kurt-stolle/tue-dbl-venus/docs/pin layout.txt

Digital 0 - RX ZigBee module
Digital 1 - TX ZigBee module
Digital 2 - Ultrasonic Top (Echo Pin)
Digital 3 (PWM) - Ultrasonic Bottom (Echo Pin)
Digital 4 - Infrared Sample (bottom)
Digital 5 (PWM) - Infrared Lab (top)
Digital 6 (PWM) - Ultrasonic Bottom (Trigger Pin)
Digital 7 - left encoder
Digital 8 - right encoder
Digital 9 (PWM) - Ultrasonic Top (Trigger Pin)
Digital 10 (PWM) - grabber servo
Digital 11 (PWM) - ultrasound servo
Digital 12 - left servo
Digital 13 - right servo
Analog 0 - IR Left
Analog 1 - IR Right
Analog 2 - not used
Analog 3 - not used
Analog 4 - not used
Analog 5 - not used
