kurt-stolle/tue-dbl-venus/docs/Meetings/Agenda/Meeting Agenda 07.06.docx

# Meeting Agenda 07.06.16

- What we did last week
- What to do this week - Task division for this week - When to meet on Friday
- Who got a camera we can use?
- AOB
