kurt-stolle/tue-dbl-venus/docs/Meetings/Notes/2016-05-17.docx

# Venus OGO meeting

2016-05-17

De vergadering wordt gestart om 10:01

# Vorige week

…

# Status

Software loopt volgens schema.

Er moet een oplossing bedacht worden voor het bijhouden van de afgelegde snelheid.

Het IR-circuit werkt, alleen is een van de circuits niet goed gesoldeerd.

Test plan is nog niet mee begonnen.

Er is nog niet begonnen met tactiek.

# Planning volgende week

Alle test plans moeten af zijn.

Deze week moet communicatie en navigatie werken bijna.

# WVTTK

…
