kurt-stolle/tue-dbl-venus/docs/Design Report/gantt chart group 32.pdf

Venus Exploration Group 32 | May 10, 2016 http://

Project manager
Project dates | Apr 19, 2016 - Jun 21, 2016
Completion | 0%
Tasks | 28
Resources | 5

Gantt chart for group 32

Name | Begin date | End date
Task division | 4/19/16 | 4/25/16
Global setup | 4/19/16 | 4/25/16
Strategy choice | 4/19/16 | 4/25/16
Programming basics | 4/26/16 | 4/28/16
Utilitarian functions | 4/26/16 | 4/28/16
Examining robot functionality | 4/29/16 | 5/2/16
Design report | 4/26/16 | 4/29/16
Testing basic functionality on robot | 5/3/16 | 5/9/16
Developing basic algorithm | 5/3/16 | 5/9/16
Overall task division | 5/3/16 | 5/3/16
Making gantt chart | 5/3/16 | 5/6/16
Fix grabber | 5/3/16 | 5/3/16
Design circuit IR-sensor | 5/3/16 | 5/9/16
Testing ultrasonic sensor | 5/3/16 | 5/9/16
Testing XBee sensor | 5/3/16 | 5/9/16
Test IR-circuit | 5/10/16 | 5/12/16
Test plan: Identifying and grabbing the rocks | 5/10/16 | 5/16/16
Test plan; Boundary and cliff recognition | 5/13/16 | 5/16/16
Test plan: Detecting mountains | 5/13/16 | 5/16/16
Test plan: Communication | 5/17/16 | 5/19/16
Test plan: Navigation | 5/20/16 | 5/23/16
Choose strategy | 5/17/16 | 5/17/16
Testing IR sensors | 5/24/16 | 5/26/16
Main algorithm | 5/18/16 | 5/26/16
Final testing | 5/31/16 | 6/6/16
Write final report | 6/7/16 | 6/13/16
Video presentation deadline | 6/16/16 | 6/16/16
Final report deadline | 6/20/16 | 6/20/16
Venus Exploration Group 32 | May 10, 2016
Tasks | 2

Name | Default role
Kurt | undefined
Loek | undefined
Tim | undefined
Niels | undefined
Marius | undefined
Resources | 3

## Gantt Chart

4

Name | Begin date | End date
Task division | 4/19/16 | 4/25/16
Global setup | 4/19/16 | 4/25/16
Strategy choice | 4/19/16 | 4/25/16
Programming basics | 4/26/16 | 4/28/16
Utilitarian functions | 4/26/16 | 4/28/16
Examining robot funct... 4/29/16 | 5/2/16
Design report | 4/26/16 | 4/29/16
Testing basic function... 5/3/16 | 5/9/16
Developing basic algo... 5/3/16 | 5/9/16
Overall task division | 5/3/16 | 5/3/16
Making gantt chart | 5/3/16 | 5/6/16
Fix grabber | 5/3/16 | 5/3/16
Design circuit IR-sensor 5/3/16 | 5/9/16
Testing ultrasonic sens...5/3/16 | 5/9/16
Testing XBee sensor | 5/3/16 | 5/9/16
Test IR-circuit | 5/10/16 | 5/12/16
Test plan: Identifying ... 5/10/16 | 5/16/16
Test plan; Boundary a... 5/13/16 | 5/16/16
Test plan: Detecting m...5/13/16 | 5/16/16
Test plan: Communica... 5/17/16 | 5/19/16
Test plan: Navigation | 5/20/16 | 5/23/16
Choose strategy | 5/17/16 | 5/17/16
Testing IR sensors | 5/24/16 | 5/26/16
Main algorithm | 5/18/16 | 5/26/16
Final testing | 5/31/16 | 6/6/16
Write final report | 6/7/16 | 6/13/16
Video presentation de... 6/16/16 | 6/16/16
Final report deadline | 6/20/16 | 6/20/16
April 2016 | May 2016 | June 2016 | July 2016
Week 17 | Week 18 | Week 19 | Week 20 | Week 21 | Week 22 | Week 23 | Week 24 | Week 25 | Week 26 | Week 27
4/17/16 | 4/24/16 | 5/1/16 | 5/8/16 | 5/15/16 | 5/22/16 | 5/29/16 | 6/5/16 | 6/12/16 | 6/19/16 | 6/26/16

## Resources Chart

5

Name | Default role
Kurt | undefined
Loek | undefined
Tim | undefined
Niels | undefined
Marius | undefined
300% | 300% | 200%
300% | 300% | 200%
300% | | 200%

300%

300% | | 200%
April 2016 | May 2016 | June 2016 | July 2016
Week 17 | Week 18 | Week 19 | Week 20 | Week 21 | Week 22 | Week 23 | Week 24 | Week 25 | Week 26 | Week 27
4/17/16 | 4/24/16 | 5/1/16 | 5/8/16 | 5/15/16 | 5/22/16 | 5/29/16 | 6/5/16 | 6/12/16 | 6/19/16 | 6/26/16
