kurt-stolle/tue-dbl-venus/docs/Design Report/Gantt project planner1.xlsx

Project Planner
 |  |  |  |  |  | Period Highlight: |  |  |  |  | 16 |  |  |  | Plan |  |  | Actual |  |  |  | % Complete |  |  |  |  | Actual (beyond plan) |  |  |  |  |  |  |  | % Complete (beyond plan)
 | PLAN | PLAN | ACTUAL | ACTUAL | PERCENT
ACTIVITY | START | DURATION | START | DURATION | COMPLETE | PERIODS
 |  |  |  |  |  | 1 | 2 | 3 | 4 | 5 | 6 | 7 | 8 | 9 | 10 | 11 | 12 | 13 | 14 | 15 | 16 | 17 | 18 | 19 | 20 | 21 | 22 | 23 | 24 | 25 | 26 | 27 | 28 | 29 | 30 | 31 | 32 | 33 | 34 | 35 | 36 | 37 | 38 | 39 | 40 | 41 | 42 | 43 | 44 | 45 | 46 | 47 | 48 | 49 | 50 | 51 | 52
Task division | 2 | 5 | 2 | 4 | 100%
Global setup | 2 | 6 | 2 | 6 | 100%
Strategy choice | 2 | 4 | 2 | 5 | 35%
Programming basic | 9 | 8 | 9 | 6 | 10%
Utilitarian functions | 9 | 2 | 9 | 8 | 85%
Examining robot functionality | 9 | 3 | 9 | 6 | 85%
Writing design report | 9 | 6 | 9 | 7 | 100%
Project meeting | 16 | 1 | 16 | 5 | 60%
Testing basic functionality on robot | 16 | 7 | 16 | 0 | 75%
Developing main algorithm | 16 | 5 | 16 | 0 | 100%
Start on final report | 16 | 1 | 16 | 0 | 60%
Making a task division | 16 | 3 | 16 | 0 | 0%
Activity 13 | 16 | 6 | 16 | 0 | 50%
Activity 14 | 16 | 3 | 16 | 0 | 0%
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
