kurt-stolle/tue-dbl-venus/docs/Final report/Avoid procedure 2.png

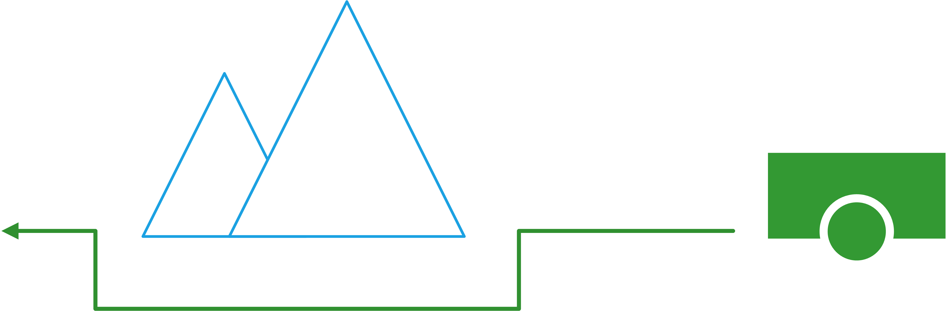
docs/Final report/Avoid procedure 2.png
