kurt-stolle/tue-dbl-venus/docs/Final report/Avoid procedure.png

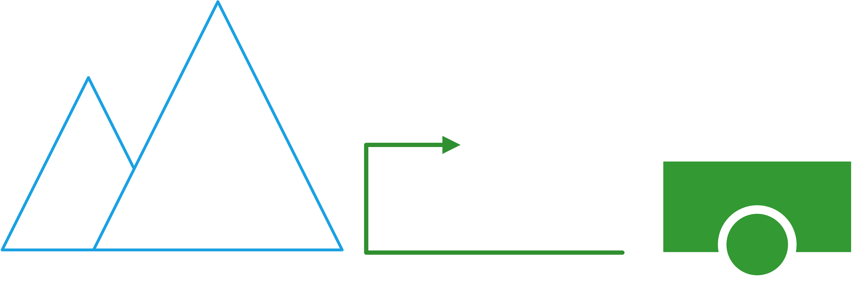
docs/Final report/Avoid procedure.png
