kurt-stolle/tue-dbl-venus/docs/Design Report/Extra Components.txt

http://www.dx.com/p/smart-car-infrared-obstacle-avoidance-sensor-black-blue-213600#.VyNO23rw9oQ
http://www.dx.com/p/hc-sr04-ultrasonic-sensor-distance-measuring-module-133696#.VyNOFXrw9oQ
http://www.dx.com/p/hc-sr04-ultrasonic-sensor-distance-measuring-modules-blue-4-pcs-400214#.VyNPm3rw9oQ
