kurt-stolle/tue-dbl-venus/docs/Servo/Test code Venus.jpg

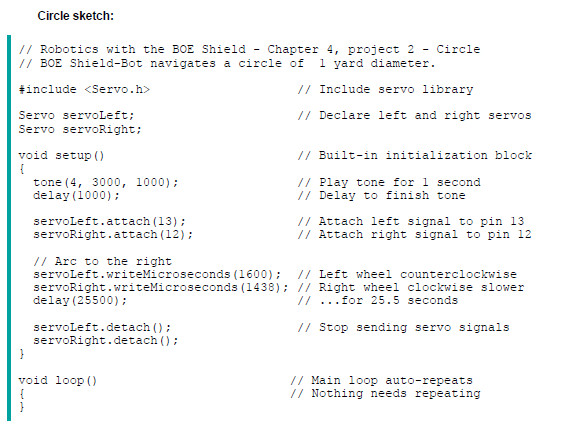
docs/Servo/Test code Venus.jpg
