kurt-stolle/tue-dbl-venus/docs/Final report/System breakdown.pdf

## Controller

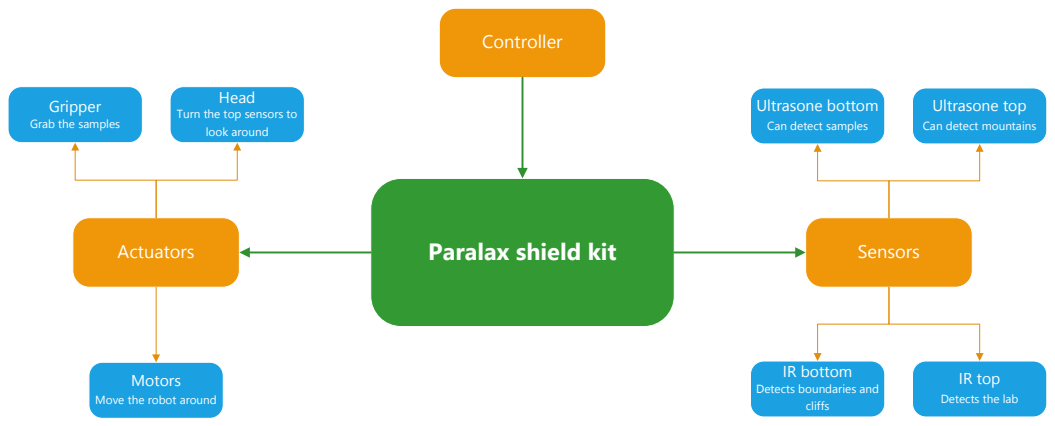
[picture p19: page 1]
Actuators; Paralax shield kit; Sensors; cliffs

Head
Turn the top sensors to
look around

Gripper
Grab the samples

Ultrasone bottom
Can detect samples

Ultrasone top
Can detect mountains

IR bottom
Detects boundaries and

Motors
Move the robot around

IR top
Detects the lab
