kurt-stolle/tue-dbl-venus/arduino/main/main.ino

/*
    TU/e Venus OGO
    Main
    Arduino Logic
*/

/*
   Includes
*/

#define DEBUG

#include "RobotController.h"
#include "Layout.h"
#include "ControlThread.h"
#include "Ultrasonic.h"
#include "TimerOne.h"
#include "Infrared.h"

#if ALGORITHM == 1
#include "CalibrationAlgorithm.h"
#define _ALGORITHM_ CalibrationAlgorithm
#elif ALGORITHM == 2
#include "ScoutAlgorithm.h"
#define _ALGORITHM_ ScoutAlgorithm
#elif ALGORITHM == 3
#include "CollectorAlgorithm.h"
#define _ALGORITHM_ CollectorAlgorithm
#endif

/*
   General variables
*/
RobotController* robotController;
ControlThread* driveThread;
ControlThread* scanThread;

// Interrupt functions
void driveCallback();
void scanCallback();
void timerCallback();
void echoCallback();
void echoAuxCallback();

// Arduino functions
void setup();
void loop();

// Algorithm
_ALGORITHM_ * alg;

/*
   Setup & Thread control
*/

void setup() {
#ifdef DEBUG
  Serial.begin(9600);
#endif

  // Create an instance for the robot controller
  robotController = new RobotController();

  // Setup threads
  driveThread = new ControlThread(driveCallback);
  scanThread = new ControlThread(scanCallback);

  // Attach an interrupt for the ultrasound
  attachInterrupt(digitalPinToInterrupt(PIN_ECHO_ULTRASOUND), echoCallback, CHANGE);
  attachInterrupt(digitalPinToInterrupt(PIN_ECHO_ULTRASOUNDAUX), echoAuxCallback, CHANGE);

  Timer1.initialize(50 * 1000L);
  Timer1.attachInterrupt(timerCallback);

  // Setup algo
  alg = new _ALGORITHM_ ();
  alg->setup(robotController);
}

void timerCallback() {
  /* Calls the threadcontroller to check whether
     threads in the pool need to be executed at this moment. */

  controlThreadPool.run();
}

/*
   Main logic and callback functions
*/

void loop() {
  alg->loop(robotController);
}

void driveCallback() {
  /* Handles all tasks concerning the driving state of
     the robot (updating servo acceleration etc.) */

  robotController->UpdateMovement();
}

void scanCallback() {
  /* Sends a pulse from the main ultrasonic sensor
     on the head of the robot */

  robotController->Scan();
}

void echoCallback() {
  /* Listens to a response from the robot's US sensor
     and sets its distance variable to a new value */

  robotController->USListen();
}

void echoAuxCallback() {
  /* Listens to a response from the robot's US sensor
     and sets its distance variable to a new value */

  robotController->USListenAux();
}
