kurt-stolle/tue-dbl-venus/arduino/main/ControlThread.h

/*
*  TU/e Venus OGO
*  ControlThread
*  Generic thread for concurrent tasks
*/

#ifndef ControlThread_h
#define ControlThread_h

#include "Thread.h"
#include "ThreadController.h"

extern ThreadController controlThreadPool;

class ControlThread : public Thread {
public:
	ControlThread(void(*f)());
	void run();
private:
	void(*runtime)();
};

#endif
