kurt-stolle/tue-dbl-venus/arduino/main/ThreadController.h

/*
 *  TU/e Venus OGO
 *  ThreadController 
 *  Header
 */


#ifndef ThreadController_h
#define ThreadController_h

#include "Thread.h"
#include "inttypes.h"

#define MAX_THREADS		15

class ThreadController: public Thread{
protected:
	Thread* thread[MAX_THREADS];
	int cached_size;
public:
	ThreadController(unsigned long _interval = 0);

	// run() Method is overrided
	void run();

	// Adds a thread in the first available slot (remove first)
	// Returns if the Thread could be added or not
	bool add(Thread* _thread);

	// remove the thread (given the Thread* or ThreadID)
	void remove(int _id);
	void remove(Thread* _thread);

	// Removes all threads
	void clear();

	// Return the quantity of Threads
	int size(bool cached = true);

	// Return the I Thread on the array
	// Returns NULL if none found
	Thread* get(int index);
};

#endif
