kurt-stolle/tue-dbl-venus/arduino/main/Infrared.h

/*
   TU/e Venus OGO
   Infrared
   Library for simple infrared functions
*/

#ifndef Infrared_h
#define Infrared_h

#include "Layout.h"

class Infrared {
  public:
    enum Color {
      WHITE = 1,
      GRAY = 2,
      BLACK = 0
    };

    void Attach(pin measurePin, bool longRange);
    Color GetColor();           // Returns measured color
  private:
    pin measurePin;
    bool longRange;

    enum Threshold {
      THRESH_WHITE = 150,
      THRESH_GRAY = 150,
    };
};








#endif
