kurt-stolle/tue-dbl-venus/(commit log)

2016-04-26 Updated arduino
2016-04-29 Pin Layout
2016-05-01 Small servo changes
2016-05-03 New Pin layout
    All arduino output pins are now included
2016-05-03 Fixed headers and prototype classes
    [RobotController.cpp, RobotController.h, Ultrasonic.cpp, Ultrasonic.h, main.ino]
2016-05-03 Thread begin
2016-05-10 Arduino debugging shit blaba
2016-05-13 Ultrasonic fixed. Let's upload it before it breaks again..
    [RobotController.cpp, Ultrasonic.cpp, main.ino]
2016-05-13 Servotimer 2 fix
2016-05-13 Network docs
    [Network Configuration.txt]
2016-05-17 2 in 1 IR sensor
2016-05-17 IR sensor long range
2016-05-23 IR sensor data and test code
2016-05-23 Some code for the IR sensors
    Does complie, but we should discuss what exactly is the input for this
    function
2016-05-27 Driving fixed, test routine made
    [Layout.h, RobotController.cpp, RobotController.h, main.ino]
2016-05-27 Code for auxiliary ultrasonic sensor
2016-05-31 Infrared & ultrasonic changes
2016-05-31 servo US updated
2016-06-03 Update pin layout.txt
2016-06-06 fixes, at least compiles a bit now.
    [Algorithm.cpp, CalibrationAlgorithm.h, CollectorAlgorithm.h, RobotController.cpp, ScoutAlgorithm.cpp, ScoutAlgorithm.h, main.ino]
2016-06-10 Updated calibration
2016-06-10 Avoiding cliff in Collector algorithm
    Turning does not work, robot get stuck in:
    while (c->IsPerforming(Action::TURNING))
    [CollectorAlgorithm.cpp]
2016-06-14 Flow charts for report
2016-06-16 IR average + small fixes
    [Algorithm.cpp, CalibrationAlgorithm.cpp, ControlThread.cpp, Infrared.cpp, Infrared.h, RobotController.cpp, ScoutAlgorithm.cpp, main.ino]
